aaronraj11/MES4-MCU/MES4-MCU-BOM.csv

Designator | Value | Footprint | LCSC | Qty
BZ1 | KLJ-5018-5040 | MES4-MCU:Buzzer_KLJ-5018-5040 | C18186309 | 1
C1,C2,C5 | 10uF 25V | Capacitor_SMD:C_0805_2012Metric | C15850 | 3
C3,C4,C6,C7,C8,C9,C10 | 100nF | Capacitor_SMD:C_0402_1005Metric | C1525 | 7
D1 | NUP2105LT1G | Package_TO_SOT_SMD:SOT-23 | C14486 | 1
D2 | SMF6.0A | Diode_SMD:D_SMF | C19077499 | 1
D3 | 1N4148WS | Diode_SMD:D_SOD-323 | C2128 | 1
LED1 | Red | LED_SMD:LED_0805_2012Metric | C84256 | 1
LED2 | Green | LED_SMD:LED_0805_2012Metric | C2297 | 1
LED3 | White | LED_SMD:LED_0805_2012Metric | C34499 | 1
LED4 | Yellow | LED_SMD:LED_0805_2012Metric | C2296 | 1
Q1,Q2,Q4 | MMBT3904 | Package_TO_SOT_SMD:SOT-23 | C20526 | 3
Q3 | AO3400A | Package_TO_SOT_SMD:SOT-23 | C20917 | 1
R1,R2,R3,R4 | 1k | Resistor_SMD:R_0402_1005Metric | C11702 | 4
R5,R6,R9,R13,R15 | 10k | Resistor_SMD:R_0402_1005Metric | C25744 | 5
R7 | 120 | Resistor_SMD:R_0603_1608Metric | C22787 | 1
R8 | 20k | Resistor_SMD:R_0402_1005Metric | C25765 | 1
R12 | 4.7k | Resistor_SMD:R_0402_1005Metric | C25900 | 1
R14 | 22 | Resistor_SMD:R_0402_1005Metric | C25092 | 1
R16 | 0 | Resistor_SMD:R_0402_1005Metric | C17168 | 1
U1 | STM32G0B1KBT6 | Package_QFP:LQFP-32_7x7mm_P0.8mm | C5270165 | 1
U2 | TLV76733DRVR | Package_SON:WSON-6-1EP_2x2mm_P0.65mm_EP1x1.6mm | C2848334 | 1
U3 | SN65HVD230DR | Package_SO:SOIC-8_3.9x4.9mm_P1.27mm | C12084 | 1
X1 | 8MHz SX2M8.000M20F30TNN | MES4-MCU:Oscillator_SCTF_SX2M_2.5x2.0mm | C2901594 | 1
