aaronraj11/MES4-MCU/MES4-MCU.kicad_pcb

## KiCad design MES4-MCU.kicad_pcb (2026-10-16)

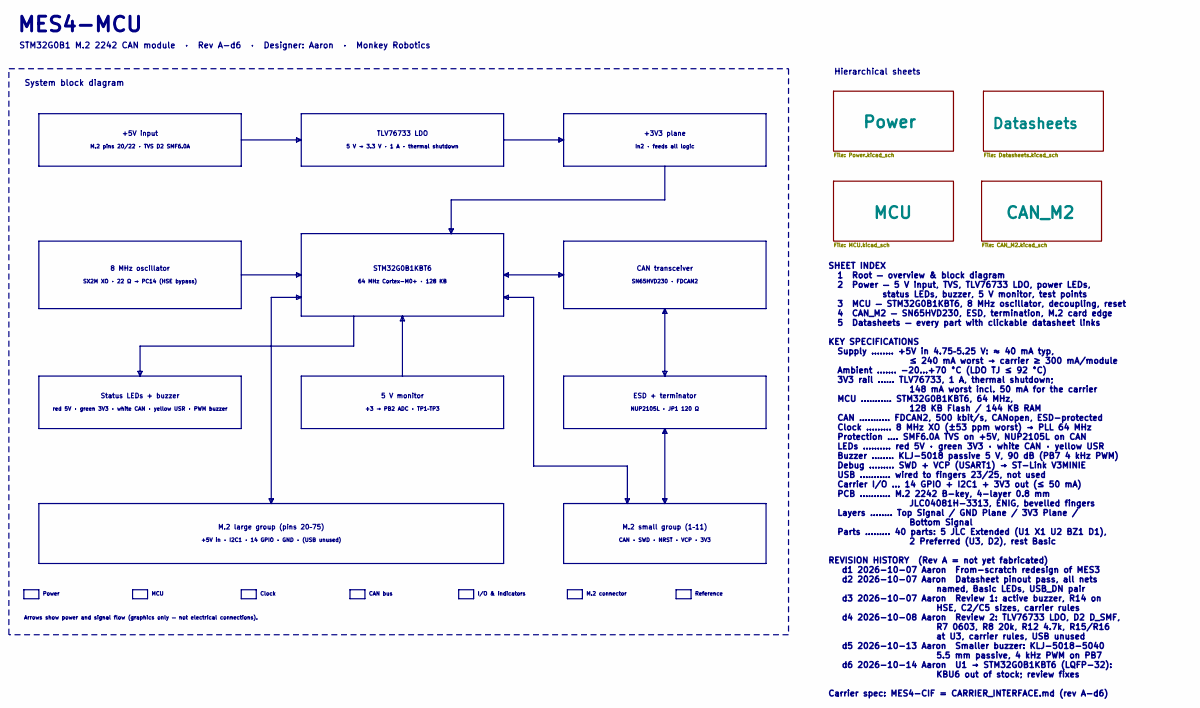
[picture p3: schematic MES4-MCU.kicad_sch, MES4-MCU – Overview]

Notes on the sheet:
+5V input
ESD + terminator
CAN transceiver
CAN bus
+5V in · I2C1 · 14 GPIO · GND · (USB unused)
System block diagram
M.2 pins 20/22 · TVS D2 SMF6.0A
NUP2105L · JP1 120 Ω
SX2M XO · 22 Ω → PC14 (HSE bypass)
Status LEDs + buzzer
STM32G0B1 M.2 2242 CAN module · Rev A-d6 · Designer: Aaron · Monkey Robotics
I/O & indicators
SHEET INDEX 1 Root — overview & block diagram 2 Power — 5 V input, TVS, TLV76733 LDO, power LEDs, status LEDs, buzzer, 5 V monitor, test points 3 MCU — STM32G0B1KBT6, 8 MHz oscillator, decoupling, reset 4 CAN_M2 — SN65HVD230, ESD, termination, M.2 card edge 5 Datasheets — every part with clickable 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
M.2 large group (pins 20–75)
TLV76733 LDO
64 MHz Cortex-M0+ · 128 KB
Arrows show power and signal flow (graphics only — not electrical connections).
Reference
STM32G0B1KBT6
SN65HVD230 · FDCAN2
÷3 → PB2 ADC · TP1–TP3
+3V3 plane
M.2 connector
Hierarchical sheets
red 5V · green 3V3 · white CAN · yellow USR · PWM buzzer
5 V monitor
Power
CAN · SWD · NRST · VCP · 3V3
M.2 small group (1–11)
Clock
5 V → 3.3 V · 1 A · thermal shutdown
In2 · feeds all logic
MES4-MCU
8 MHz oscillator
MCU

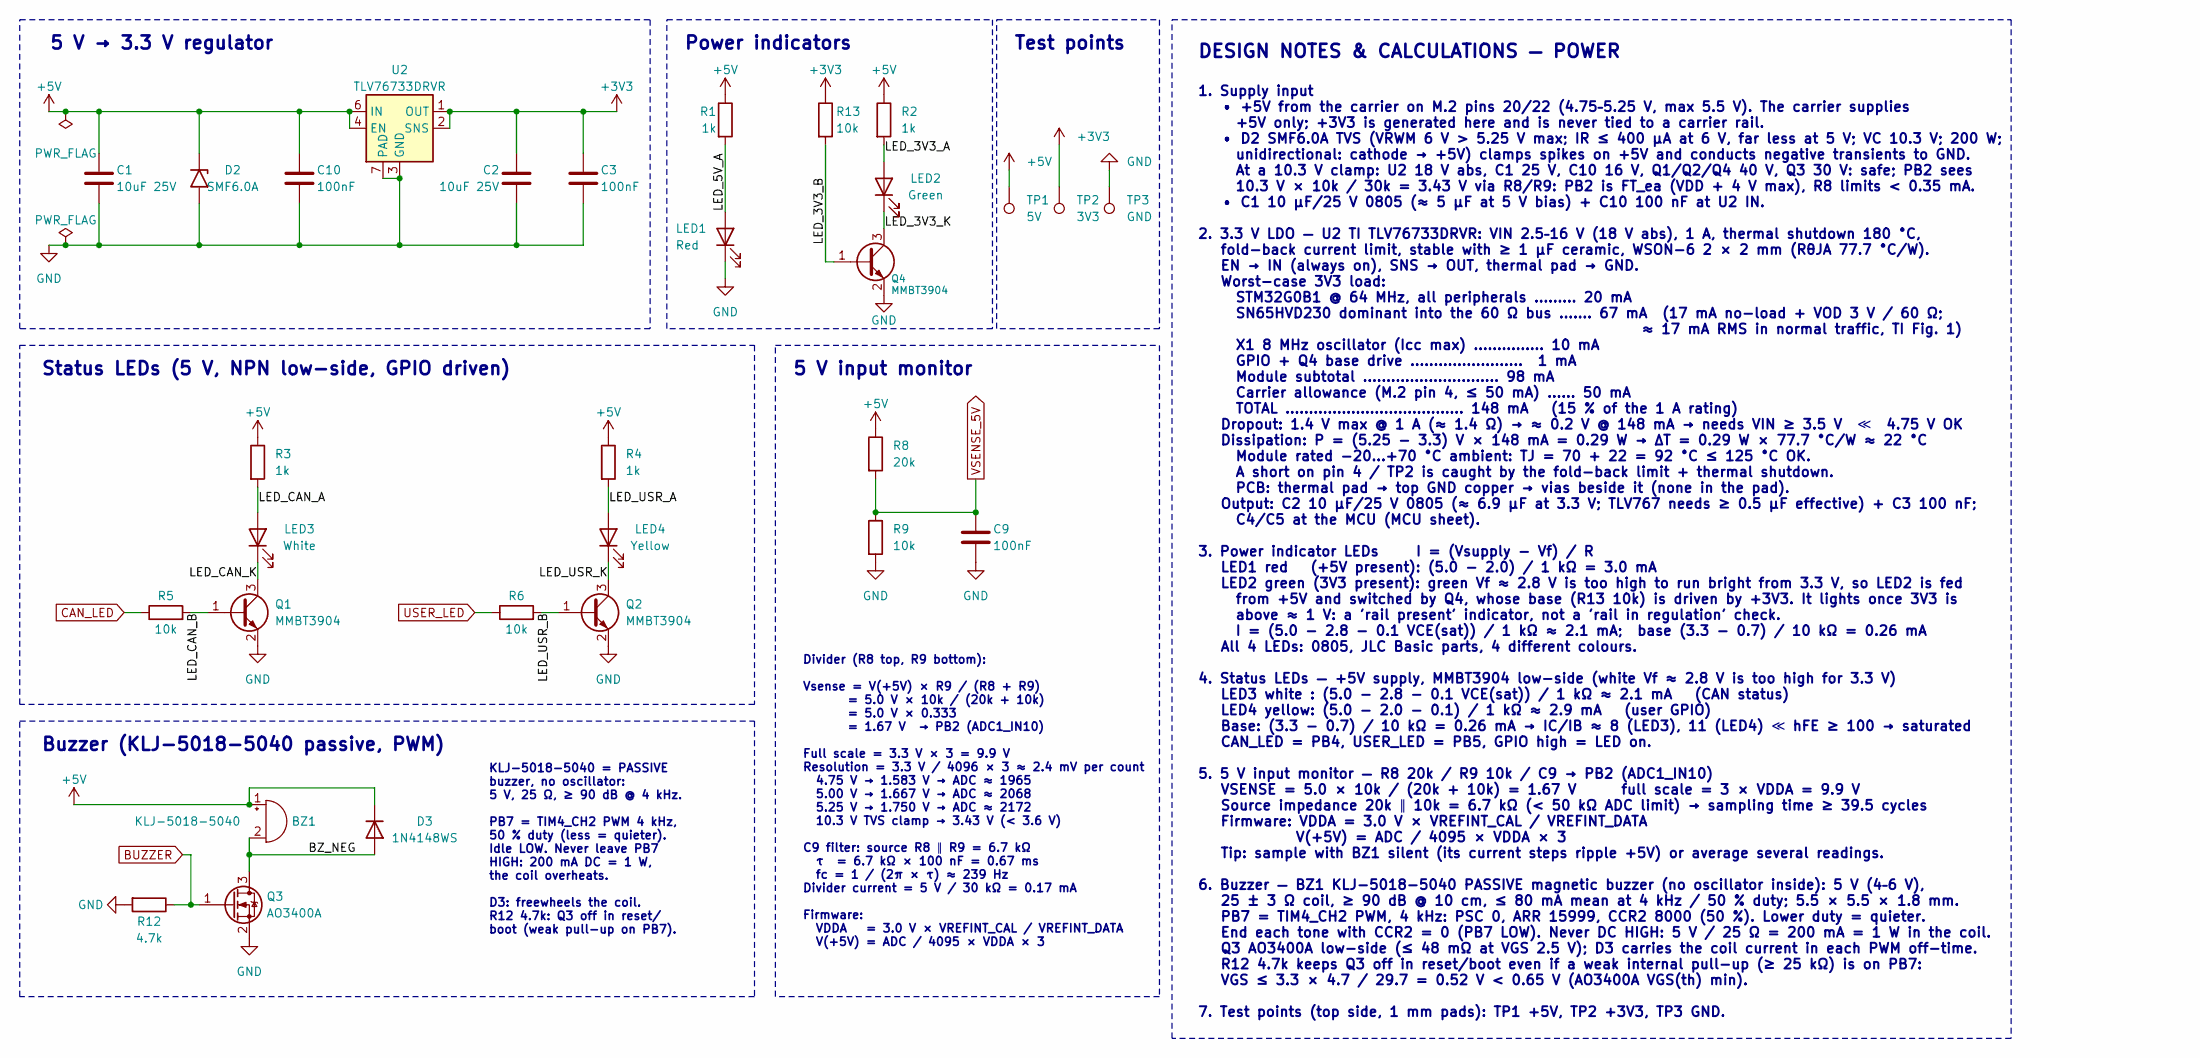
[picture p4: schematic Power.kicad_sch, MES4-MCU – Power, LEDs, buzzer & monitoring]

Parts:
BZ1: KLJ-5018-5040; Buzzer_KLJ-5018-5040; MPN KLJ-5018-5040; LCSC C18186309
C1, C2: 10uF 25V; C_0805_2012Metric; MPN CL21A106KAYNNNE; LCSC C15850
C3, C9, C10: 100nF; C_0402_1005Metric; MPN CL05B104KO5NNNC; LCSC C1525
D2: SMF6.0A; D_SMF; MPN SMF6.0A; LCSC C19077499
D3: 1N4148WS; D_SOD-323; MPN 1N4148WS; LCSC C2128
LED1: Red; LED_0805_2012Metric; MPN NCD0805R1; LCSC C84256
LED2: Green; LED_0805_2012Metric; MPN KT-0805G; LCSC C2297
LED3: White; LED_0805_2012Metric; MPN KT-0805W; LCSC C34499
LED4: Yellow; LED_0805_2012Metric; MPN KT-0805Y; LCSC C2296
Q1, Q2, Q4: MMBT3904; SOT-23; MPN MMBT3904; LCSC C20526
Q3: AO3400A; SOT-23; MPN AO3400A; LCSC C20917
R1, R2, R3, R4: 1k; R_0402_1005Metric; MPN 0402WGF1001TCE; LCSC C11702
R5, R6, R9, R13: 10k; R_0402_1005Metric; MPN 0402WGF1002TCE; LCSC C25744
R8: 20k; R_0402_1005Metric; MPN 0402WGF2002TCE; LCSC C25765
R12: 4.7k; R_0402_1005Metric; MPN 0402WGF4701TCE; LCSC C25900
TP1: 5V; TestPoint_Pad_D1.0mm
TP2: 3V3; TestPoint_Pad_D1.0mm
TP3: GND; TestPoint_Pad_D1.0mm
U2: TLV76733DRVR; WSON-6-1EP_2x2mm_P0.65mm_EP1x1.6mm; MPN TLV76733DRVR; LCSC C2848334

Connections:
+3V3: C2.1, C3.1, R13.1, TP2.1, U2.1 (OUT), U2.2 (SNS); also elsewhere on the board
+5V: BZ1.1 (+), C1.1, C10.1, D2.1 (A1), D3.1 (K), R1.1, R2.1, R3.1, R4.1, R8.1, TP1.1, U2.4 (EN), U2.6 (IN); also elsewhere on the board
/Power/BZ_NEG: BZ1.2 (-), D3.2 (A), Q3.3 (D)
/Power/LED_3V3_A: LED2.2 (A), R2.2
/Power/LED_3V3_B: Q4.1 (B), R13.2
/Power/LED_3V3_K: LED2.1 (K), Q4.3 (C)
/Power/LED_5V_A: LED1.2 (A), R1.2
/Power/LED_CAN_A: LED3.2 (A), R3.2
/Power/LED_CAN_B: Q1.1 (B), R5.2
/Power/LED_CAN_K: LED3.1 (K), Q1.3 (C)
/Power/LED_USR_A: LED4.2 (A), R4.2
/Power/LED_USR_B: Q2.1 (B), R6.2
/Power/LED_USR_K: LED4.1 (K), Q2.3 (C)
BUZZER: Q3.1 (G), R12.1; also elsewhere on the board
CAN_LED: R5.1; also elsewhere on the board
GND: C1.2, C2.2, C3.2, C9.2, C10.2, D2.2 (A2), LED1.1 (K), Q1.2 (E), Q2.2 (E), Q3.2 (S), Q4.2 (E), R9.2, R12.2, TP3.1, U2.3 (GND), U2.5 (GND), U2.7 (PAD); also elsewhere on the board
USER_LED: R6.1; also elsewhere on the board
VSENSE_5V: C9.1, R8.2, R9.1; also elsewhere on the board

Notes on the sheet:
5 V input monitor
DESIGN NOTES & CALCULATIONS — POWER
KLJ-5018-5040 = PASSIVE buzzer, no oscillator: 5 V, 25 Ω, ≥ 90 dB @ 4 kHz. PB7 = TIM4_CH2 PWM 4 kHz, 50 % duty (less = quieter). Idle LOW. Never leave PB7 HIGH: 200 mA DC = 1 W, the coil overheats. D3: freewheels the coil. R12 4.7k: Q3 off in reset/ boot (weak pull-up on PB7).
Divider (R8 top, R9 bottom): Vsense = V(+5V) × R9 / (R8 + R9) = 5.0 V × 10k / (20k + 10k) = 5.0 V × 0.333 = 1.67 V → PB2 (ADC1_IN10) Full scale = 3.3 V × 3 = 9.9 V Resolution = 3.3 V / 4096 × 3 ≈ 2.4 mV per count 4.75 V → 1.583 V → ADC ≈ 1965 5.00 V → 1.667 V → ADC ≈ 2068 5.25 V → 1.750 V → ADC ≈ 2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
Status LEDs (5 V, NPN low-side, GPIO driven)
Test points
Power indicators
5 V → 3.3 V regulator
1. Supply input • +5V from the carrier on M.2 pins 20/22 (4.75–5.25 V, max 5.5 V). The carrier supplies +5V only; +3V3 is generated here and is never tied to a carrier rail. • D2 SMF6.0A TVS (VRWM 6 V > 5.25 V max; IR ≤ 400 µA at 6 V, far less at 5 V; VC 10.3 V; 200 W; unidirectional: cathode → +5V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
Buzzer (KLJ-5018-5040 passive, PWM)

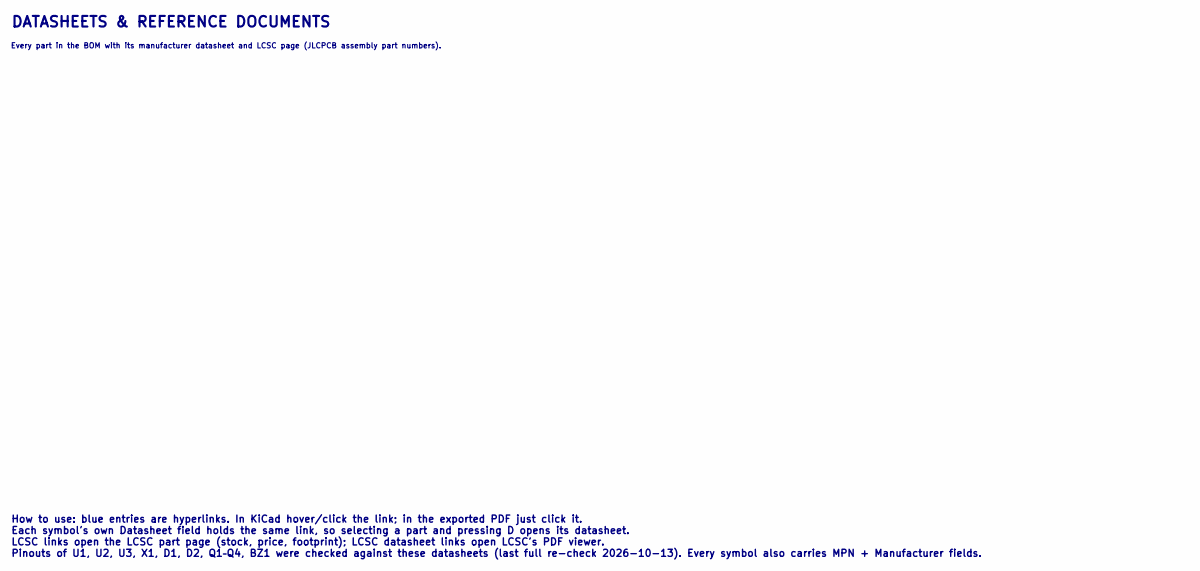
[picture p5: schematic Datasheets.kicad_sch, MES4-MCU – Datasheets & references]

Notes on the sheet:
Every part in the BOM with its manufacturer datasheet and LCSC page (JLCPCB assembly part numbers).
DATASHEETS & REFERENCE DOCUMENTS
How to use: blue entries are hyperlinks. In KiCad hover/click the link; in the exported PDF just click it. Each symbol's own Datasheet field holds the same link, so selecting a part and pressing D opens its datasheet. LCSC links open the LCSC part page (stock, price, footprint); LCSC datasheet link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

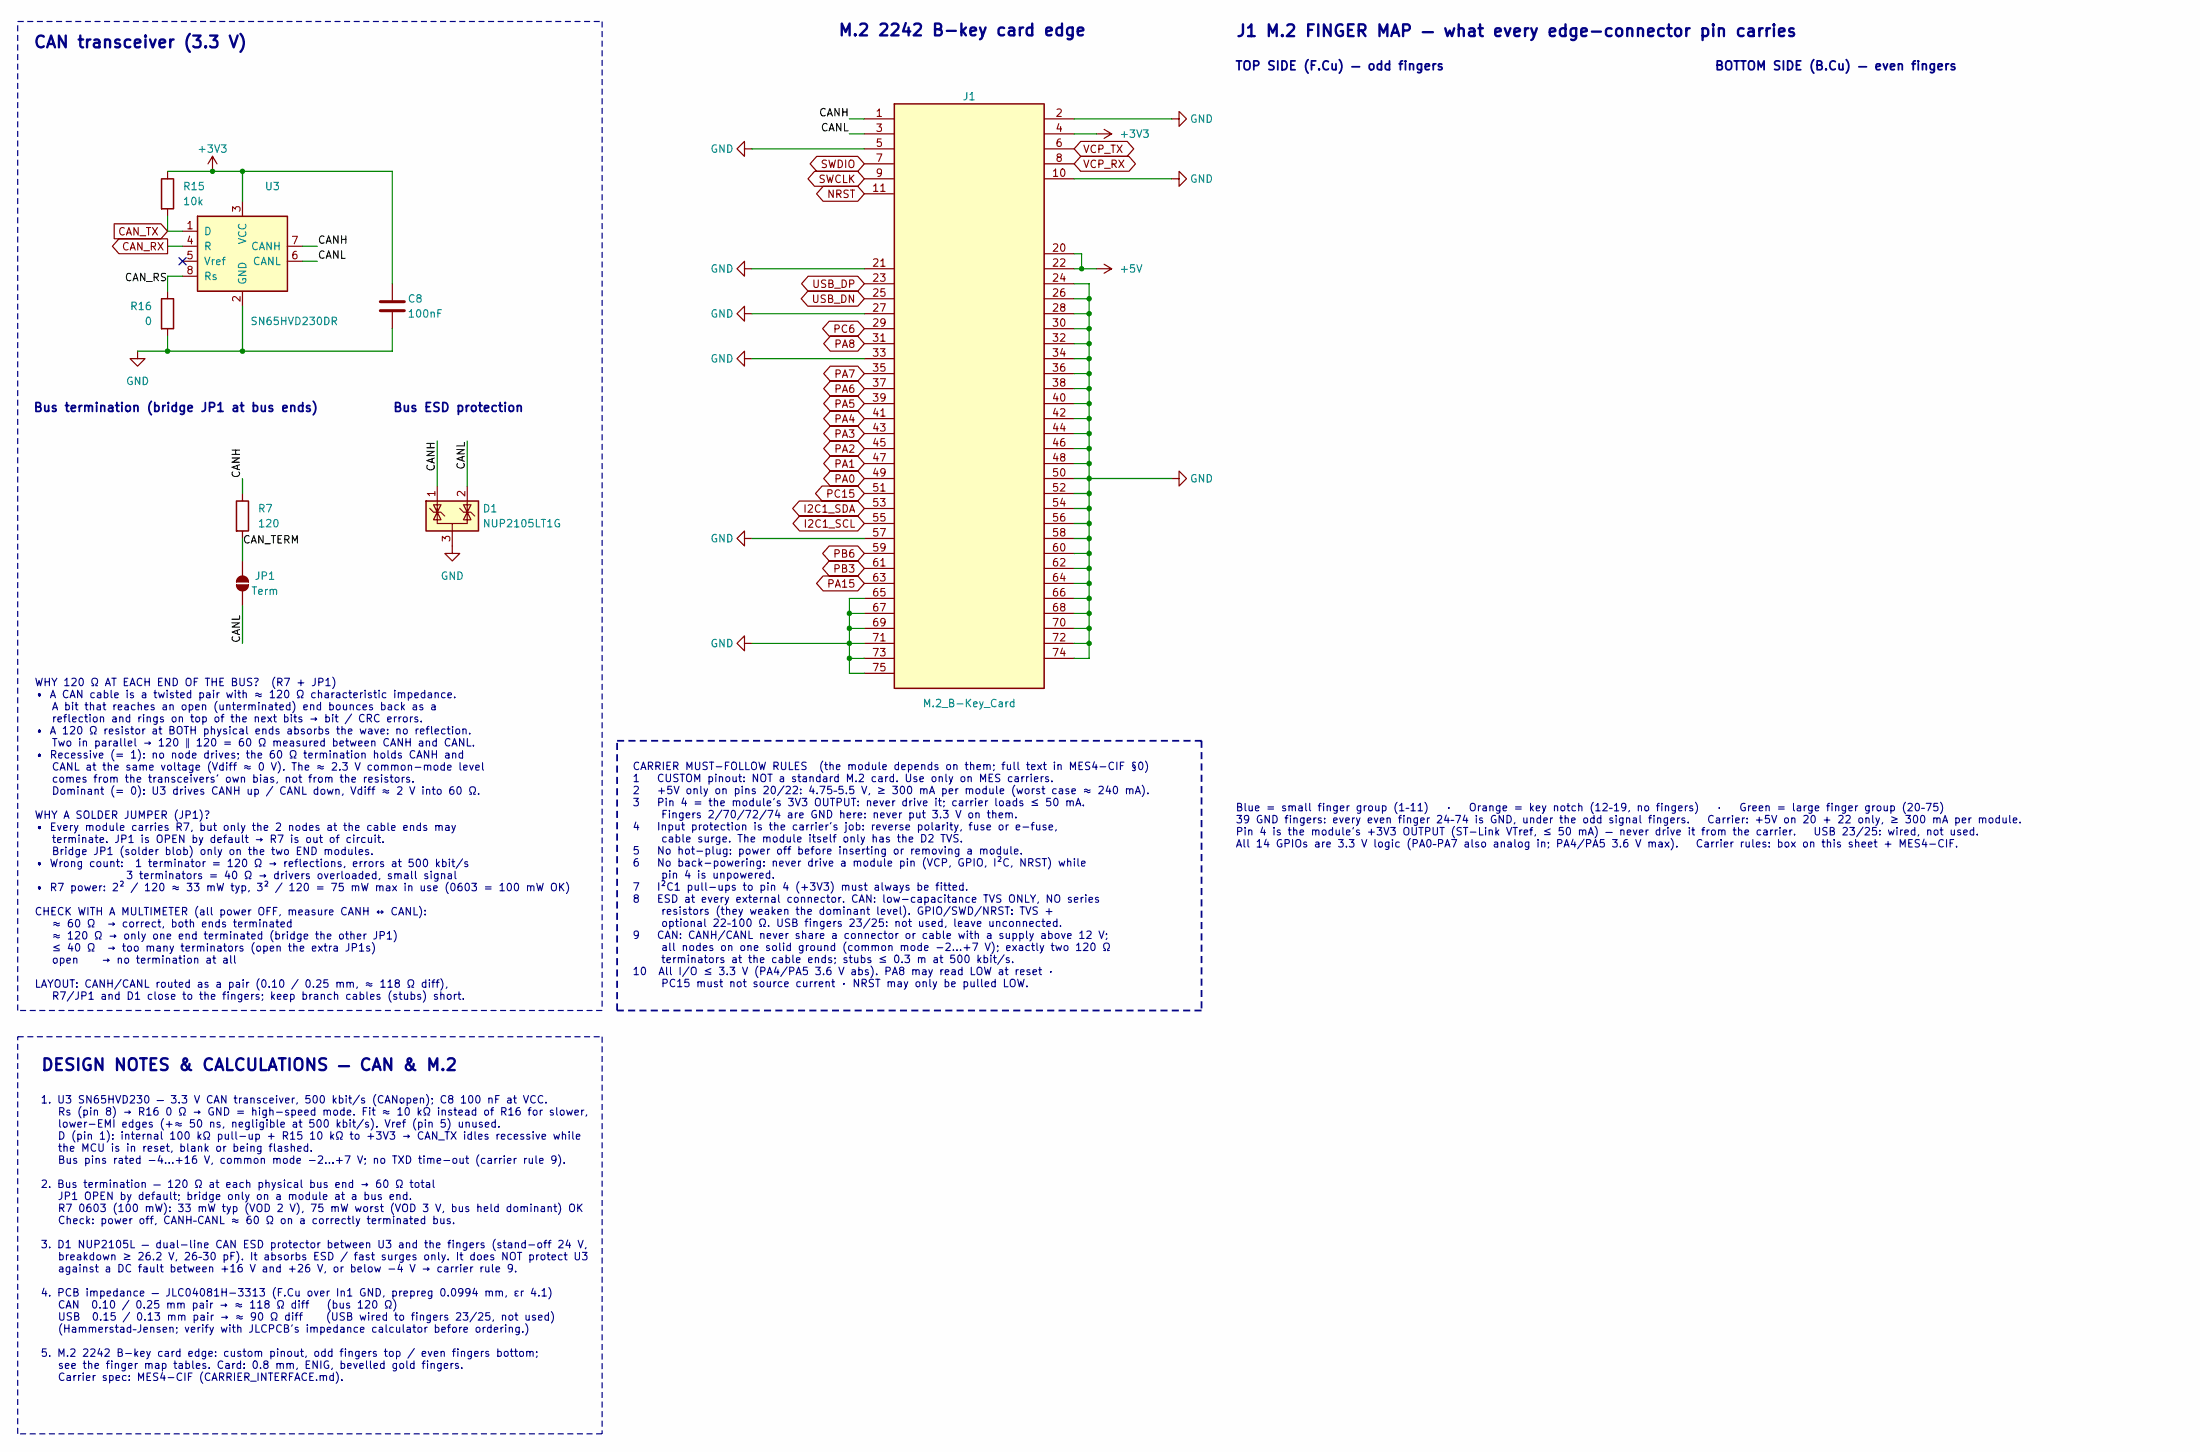
[picture p6: schematic CAN_M2.kicad_sch, MES4-MCU – CAN & M.2]

Parts:
C8: 100nF; C_0402_1005Metric; MPN CL05B104KO5NNNC; LCSC C1525
D1: NUP2105LT1G; SOT-23; MPN NUP2105LT1G; LCSC C14486
J1: M.2_B-Key_Card; M.2_2242_B-Key_Card
JP1: Term; SolderJumper-2_P1.3mm_Open_RoundedPad1.0x1.5mm
R7: 120; R_0603_1608Metric; MPN 0603WAF1200T5E; LCSC C22787
R15: 10k; R_0402_1005Metric; MPN 0402WGF1002TCE; LCSC C25744
R16: 0; R_0402_1005Metric; MPN 0402WGF0000TCE; LCSC C17168
U3: SN65HVD230DR; SOIC-8_3.9x4.9mm_P1.27mm; MPN SN65HVD230DR; LCSC C12084

Connections:
+3V3: C8.1, J1.4 (+3V3), R15.1, U3.3 (VCC); also elsewhere on the board
+5V: J1.20 (+5V), J1.22 (+5V); also elsewhere on the board
/CAN_M2/CANH: D1.1 (K), J1.1 (CANH), R7.1, U3.7 (CANH)
/CAN_M2/CANL: D1.2 (K), J1.3 (CANL), JP1.2 (B), U3.6 (CANL)
/CAN_M2/CAN_RS: R16.1, U3.8 (Rs)
/CAN_M2/CAN_TERM: JP1.1 (A), R7.2
CAN_RX: U3.4 (R); also elsewhere on the board
CAN_TX: R15.2, U3.1 (D); also elsewhere on the board
GND: C8.2, D1.3 (A), J1.2 (GND), J1.5 (GND), J1.10 (GND), J1.21 (GND), J1.24 (GND), J1.26 (GND), J1.27 (GND), J1.28 (GND), J1.30 (GND), J1.32 (GND), J1.33 (GND), J1.34 (GND), J1.36 (GND), J1.38 (GND), J1.40 (GND), J1.42 (GND), J1.44 (GND), J1.46 (GND), J1.48 (GND), J1.50 (GND), J1.52 (GND), J1.54 (GND), J1.56 (GND), J1.57 (GND), J1.58 (GND), J1.60 (GND), J1.62 (GND), J1.64 (GND), J1.65 (GND), J1.66 (GND), J1.67 (GND), J1.68 (GND), J1.69 (GND), J1.70 (GND), J1.71 (GND), J1.72 (GND), J1.73 (GND), J1.74 (GND), J1.75 (GND), R16.2, U3.2 (GND); also elsewhere on the board
I2C1_SCL: J1.55 (I2C1_SCL); also elsewhere on the board
I2C1_SDA: J1.53 (I2C1_SDA); also elsewhere on the board
NRST: J1.11 (NRST); also elsewhere on the board
PA0: J1.49 (PA0); also elsewhere on the board
PA1: J1.47 (PA1); also elsewhere on the board
PA2: J1.45 (PA2); also elsewhere on the board
PA3: J1.43 (PA3); also elsewhere on the board
PA4: J1.41 (PA4); also elsewhere on the board
PA5: J1.39 (PA5); also elsewhere on the board
PA6: J1.37 (PA6); also elsewhere on the board
PA7: J1.35 (PA7); also elsewhere on the board
PA8: J1.31 (PA8); also elsewhere on the board
PA15: J1.63 (PA15); also elsewhere on the board
PB3: J1.61 (PB3); also elsewhere on the board
PB6: J1.59 (PB6); also elsewhere on the board
PC6: J1.29 (PC6); also elsewhere on the board
PC15: J1.51 (PC15); also elsewhere on the board
SWCLK: J1.9 (SWCLK); also elsewhere on the board
SWDIO: J1.7 (SWDIO); also elsewhere on the board
USB_DN: J1.25 (USB_DM); also elsewhere on the board
USB_DP: J1.23 (USB_DP); also elsewhere on the board
VCP_RX: J1.8 (VCP_RX); also elsewhere on the board
VCP_TX: J1.6 (VCP_TX); also elsewhere on the board

Notes on the sheet:
Bus ESD protection
Blue = small finger group (1–11) · Orange = key notch (12–19, no fingers) · Green = large finger group (20–75) 39 GND fingers: every even finger 24–74 is GND, under the odd signal fingers. Carrier: +5V on 20 + 22 only, ≥ 300 mA per module. Pin 4 is the module's +3V3 OUTPUT (ST-Link VTref, ≤ 50 mA) 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
DESIGN NOTES & CALCULATIONS — CAN & M.2
J1 M.2 FINGER MAP — what every edge-connector pin carries
CARRIER MUST-FOLLOW RULES (the module depends on them; full text in MES4-CIF §0) 1 CUSTOM pinout: NOT a standard M.2 card. Use only on MES carriers. 2 +5V only on pins 20/22: 4.75–5.5 V, ≥ 300 mA per module (worst case ≈ 240 mA). 3 Pin 4 = the module's 3V3 OUTPUT: never drive it; carrier loads ≤ 50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
TOP SIDE (F.Cu) — odd fingers
WHY 120 Ω AT EACH END OF THE BUS? (R7 + JP1) • A CAN cable is a twisted pair with ≈ 120 Ω characteristic impedance. A bit that reaches an open (unterminated) end bounces back as a reflection and rings on top of the next bits → bit / CRC errors. • A 120 Ω resistor at BOTH physical ends absorbs the w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
M.2 2242 B-key card edge
BOTTOM SIDE (B.Cu) — even fingers
1. U3 SN65HVD230 — 3.3 V CAN transceiver, 500 kbit/s (CANopen); C8 100 nF at VCC. Rs (pin 8) → R16 0 Ω → GND = high-speed mode. Fit ≈ 10 kΩ instead of R16 for slower, lower-EMI edges (+≈ 50 ns, negligible at 500 kbit/s). Vref (pin 5) unused. D (pin 1): internal 100 kΩ pull-up + R15 10 kΩ to +3V3 → 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
CAN transceiver (3.3 V)
Bus termination (bridge JP1 at bus ends)

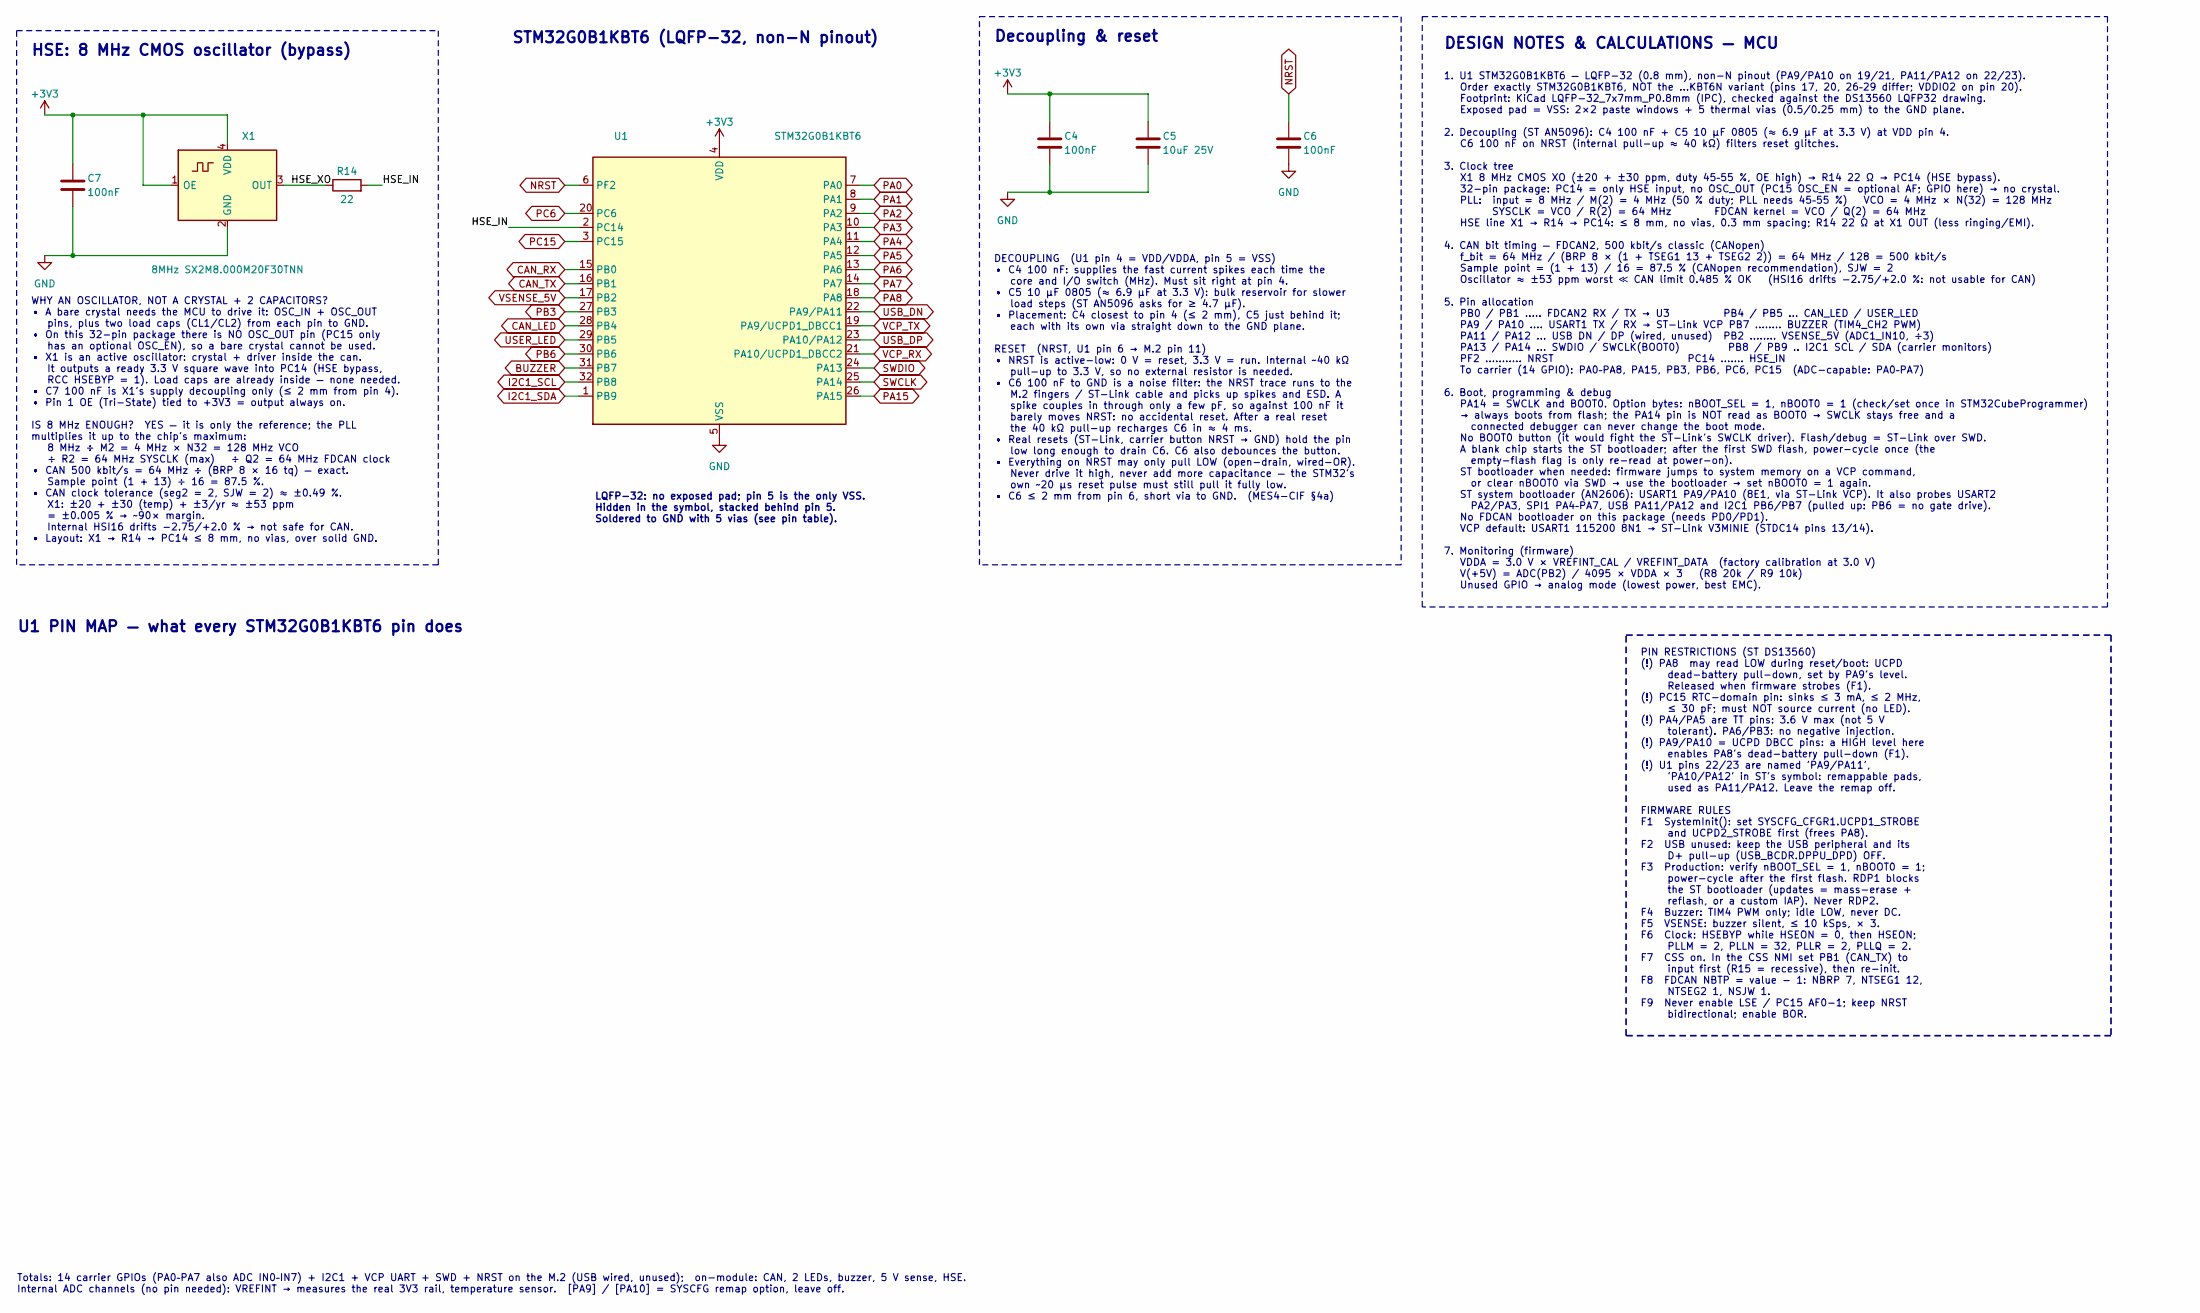
[picture p7: schematic MCU.kicad_sch, MES4-MCU – MCU]

Parts:
C4, C6, C7: 100nF; C_0402_1005Metric; MPN CL05B104KO5NNNC; LCSC C1525
C5: 10uF 25V; C_0805_2012Metric; MPN CL21A106KAYNNNE; LCSC C15850
R14: 22; R_0402_1005Metric; MPN 0402WGF220JTCE; LCSC C25092
U1: STM32G0B1KBT6; LQFP-32_7x7mm_P0.8mm; MPN STM32G0B1KBT6; LCSC C5270165
X1: 8MHz SX2M8.000M20F30TNN; Oscillator_SCTF_SX2M_2.5x2.0mm; MPN SX2M8.000M20F30TNN; LCSC C2901594

Connections:
+3V3: C4.1, C5.1, C7.1, U1.4 (VDD), X1.1 (OE), X1.4 (VDD); also elsewhere on the board
/MCU/HSE_IN: R14.2, U1.2 (PC14)
/MCU/HSE_XO: R14.1, X1.3 (OUT)
BUZZER: U1.31 (PB7); also elsewhere on the board
CAN_LED: U1.28 (PB4); also elsewhere on the board
CAN_RX: U1.15 (PB0); also elsewhere on the board
CAN_TX: U1.16 (PB1); also elsewhere on the board
GND: C4.2, C5.2, C6.2, C7.2, U1.5 (VSS), X1.2 (GND); also elsewhere on the board
I2C1_SCL: U1.32 (PB8); also elsewhere on the board
I2C1_SDA: U1.1 (PB9); also elsewhere on the board
NRST: C6.1, U1.6 (PF2); also elsewhere on the board
PA0: U1.7 (PA0); also elsewhere on the board
PA1: U1.8 (PA1); also elsewhere on the board
PA2: U1.9 (PA2); also elsewhere on the board
PA3: U1.10 (PA3); also elsewhere on the board
PA4: U1.11 (PA4); also elsewhere on the board
PA5: U1.12 (PA5); also elsewhere on the board
PA6: U1.13 (PA6); also elsewhere on the board
PA7: U1.14 (PA7); also elsewhere on the board
PA8: U1.18 (PA8); also elsewhere on the board
PA15: U1.26 (PA15); also elsewhere on the board
PB3: U1.27 (PB3); also elsewhere on the board
PB6: U1.30 (PB6); also elsewhere on the board
PC6: U1.20 (PC6); also elsewhere on the board
PC15: U1.3 (PC15); also elsewhere on the board
SWCLK: U1.25 (PA14); also elsewhere on the board
SWDIO: U1.24 (PA13); also elsewhere on the board
USB_DN: U1.22 (PA9/PA11); also elsewhere on the board
USB_DP: U1.23 (PA10/PA12); also elsewhere on the board
USER_LED: U1.29 (PB5); also elsewhere on the board
VCP_RX: U1.21 (PA10/UCPD1_DBCC2); also elsewhere on the board
VCP_TX: U1.19 (PA9/UCPD1_DBCC1); also elsewhere on the board
VSENSE_5V: U1.17 (PB2); also elsewhere on the board

Notes on the sheet:
WHY AN OSCILLATOR, NOT A CRYSTAL + 2 CAPACITORS? • A bare crystal needs the MCU to drive it: OSC_IN + OSC_OUT pins, plus two load caps (CL1/CL2) from each pin to GND. • On this 32-pin package there is NO OSC_OUT pin (PC15 only has an optional OSC_EN), so a bare crystal cannot be used. • X1 is an ac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
LQFP-32: no exposed pad; pin 5 is the only VSS. Hidden in the symbol, stacked behind pin 5. Soldered to GND with 5 vias (see pin table).
1. U1 STM32G0B1KBT6 — LQFP-32 (0.8 mm), non-N pinout (PA9/PA10 on 19/21, PA11/PA12 on 22/23). Order exactly STM32G0B1KBT6, NOT the …KBT6N variant (pins 17, 20, 26–29 differ; VDDIO2 on pin 20). Footprint: KiCad LQFP-32_7x7mm_P0.8mm (IPC), checked against the DS13560 LQFP32 drawing. Exposed pad = VSS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
Decoupling & reset
DESIGN NOTES & CALCULATIONS — MCU
STM32G0B1KBT6 (LQFP-32, non-N pinout)
PIN RESTRICTIONS (ST DS13560) (!) PA8 may read LOW during reset/boot: UCPD dead-battery pull-down, set by PA9's level. Released when firmware strobes (F1). (!) PC15 RTC-domain pin: sinks ≤ 3 mA, ≤ 2 MHz, ≤ 30 pF; must NOT source current (no LED). (!) PA4/PA5 are TT pins: 3.6 V max (not 5 V tolerant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
DECOUPLING (U1 pin 4 = VDD/VDDA, pin 5 = VSS) • C4 100 nF: supplies the fast current spikes each time the core and I/O switch (MHz). Must sit right at pin 4. • C5 10 µF 0805 (≈ 6.9 µF at 3.3 V): bulk reservoir for slower load steps (ST AN5096 asks for ≥ 4.7 µF). • Placement: C4 closest to pin 4 (≤ 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
U1 PIN MAP — what every STM32G0B1KBT6 pin does
Totals: 14 carrier GPIOs (PA0–PA7 also ADC IN0–IN7) + I2C1 + VCP UART + SWD + NRST on the M.2 (USB wired, unused); on-module: CAN, 2 LEDs, buzzer, 5 V sense, HSE. Internal ADC channels (no pin needed): VREFINT → measures the real 3V3 rail, temperature sensor. [PA9] / [PA10] = SYSCFG remap option, l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
HSE: 8 MHz CMOS oscillator (bypass)

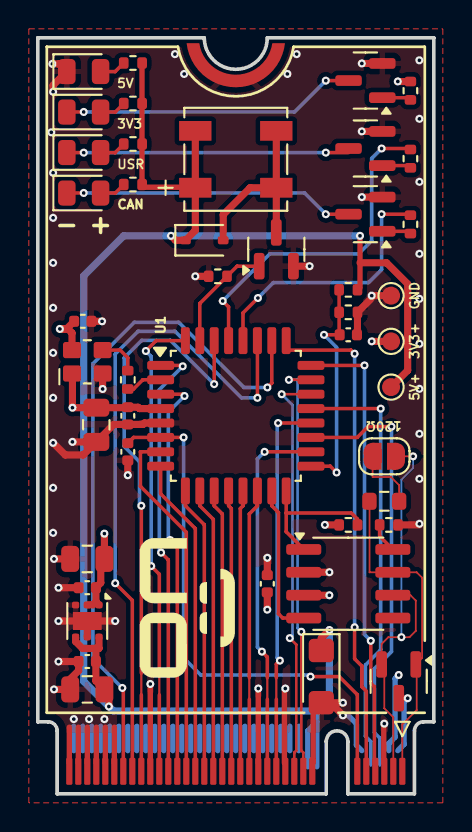
[picture p8: board MES4-MCU.kicad_pcb from above]

Board: 4 copper layers, 22.0 x 42.0 mm, 46 parts (1 on the bottom side), 49 nets.

Other parts of the board:
LOGO2: KiCad-Logo2_8mm_SilkScreen
