aaronraj11/MES4-MCU/(commit log)

2026-10-14 MES4-MCU Rev A”
    [CAN_M2.kicad_sch, Datasheets.kicad_sch, MCU.kicad_sch, MES4-MCU-BOM.csv, MES4-MCU.kicad_pcb, MES4-MCU.kicad_sch, Power.kicad_sch]
2026-10-16 PCB: user edit - unlock J1, dissolve D2 and D1/R7/JP1 groups, zone refill
    [MES4-MCU.kicad_pcb]
2026-10-26 Fix the stale exposed-pad notes; document the JLC panel and CAN limit
    MCU sheet: the LQFP-32 has no exposed pad, so drop the QFN-era paste
    window / thermal via note and the hidden-pin label text. Schematic PDF
    re-exported.
    README: the card is panelised by JLC on the order (fingers on an outer
    edge, mouse-bites, no V-cut), and CAN must never share a cable with
    more than 12 V (accepted for Rev A).
    [MCU.kicad_sch]
2026-10-29 Add LTspice simulations for the power, MCU and CAN sheets
    sim/ holds 10 benches grouped by sheet (PWR1-5, BZ1, MCU1-2, CAN1-2) plus
    MDL1, which checks the TLV76733 behavioural model against TI Fig. 7-12.
    The +5V benches are fed by the MES4-Carrier-EC 5 V path. run_sims.py runs
    them and parses the .meas results (including .step tables); make_report.py
    builds report.html. No circuit fails.
    Schematic notes updated from the results:
    - MCU sheet: NRST recharge time is about 5 ms (3-7 ms), not 4 ms (MCU2)
    - CAN_M2 rules box, rule 4: +5V must never go below -0.3 V, otherwise U2's
    body diode drags 3V3 negative (PWR3)
    [CAN_M2.kicad_sch, MCU.kicad_sch]
2026-10-29 Add the R3 review package; refresh the schematic PDF
    review/ builds MES4-MCU_Review-Package_R3.pdf (make_package.py): a cover with
    the changes since review R2, the status of the R2 findings and what to review,
    then the LTspice report printed to A4 by headless Chrome, then the schematic
    exported fresh by kicad-cli (A3), joined with pdfunite.
    MES4-MCU.pdf re-exported so it shows the 29 Oct NRST and rule 4 notes.
